sinara-hw/STM_Sys_Board/(list of files, drawings)

Other design files:
Conn_Molex_47491-0001_eec.SchLib
Conn_Molex_47491-0001_eec_0.PcbLib
Cpcis_connectors_P4_P5_P6.SchDoc
CPU.SchDoc
DIO_buffer.schdoc
Ethernet.SchDoc
LVDS_Driver.schdoc
Panel/Panel_STM_Sys_board.PcbDoc
RMII.SchDoc
ST_SYS_Board_Clocking.schdoc
ST_SYS_Board_Config.schdoc
ST_SYS_Board_FPGA.schdoc
ST_SYS_Board_FPGA_SUP.schdoc
STM_System_Board.PCBDOC
STM_System_Board.PrjPCB
STM_System_Board.schdoc
STM_System_Board_Supply.SchDoc
USB.SchDoc
USB_ETH_Mux.SchDoc
