sinara-hw/STM_Sys_Board/(threads)

Thread 3 (2023-02-17):

LVDS routing

gkasprow, 2023-02-17:
Some LVDS lanes are routed to banks that do not support LVDS at all
Moreover some of them are routed to banks supplied from 3.3V (bank 0,1,2)
Some banks need resistors to emulate LVDS outputs (0,1,2)
Lanes 8-15 of each slot must be routed to MLVDS transceivers:
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

marmeladapk, 2023-02-28:
Current differential signal compatibility:

| Signal\Slot |	1 |	2 |	3 |	4 |	5 |	6 |	7 |	8 |
| ----- | ----- | ----- | ----- | ----- | ----- | ----- | ----- | ----- |
| 0	 |	:white_check_mark: |	:heavy_check_mark: |	:heavy_check_mark: |	:heavy_check_mark: |	:heavy_check_mark: |	:white_check_mark: |	:heavy_check_mark: |	:white_check_mark: |
| 1	 |	:white_check_mark: |	:white_check_mark: |	:heavy_check_mark: |	:white_check_mark: |	:heavy_check_mark: |	❌️ |	:white_check_mark: |	❌️ |
| 2	 |	:white_check_mark: |	:heavy_check_mark: |	:heavy_check_mark: |	:heavy_check_mark: |	:heavy_check_mark: |	:heavy_check_mark: |	:heavy_check_mark: |	:heavy_check_mark: |
| 3	 |	:white_check_mark: |	❌️ |	❌️ |	❌️ |	:heavy_check_mark: |	❌️ |	:white_check_mark: |	:white_check_mark: |
| 4	 |	:white_check_mark: |	:white_check_mark: |	❌️ |	:white_check_mark: |	:white_check_mark: |	:white_check_mark: |	:white_check_mark: |	:white_check_mark: |
| 5	 |	:white_check_mark: |	:heavy_check_mark: |	:heavy_check_mark: |	:white_check_mark: |	:heavy_check_mark: |	:white_check_mark: |	:heavy_check_mark: |	❌️ |
| 6	 |	:white_check_mark: |	:white_check_mark: |	:heavy_check_mark: |	:heavy_check_mark: |	:white_check_mark: |	:white_check_mark: |	❌️ |	:white_check_mark: |
| 7	 |	:heavy_check_mark: |	:heavy_check_mark: |	:heavy_check_mark: |	:heavy_check_mark: |	:heavy_check_mark: |	:white_check_mark: |	:heavy_check_mark: |	❌️ |
| 8	 |	 |	 |	❌️ |	:heavy_check_mark: |	 |	 |	 |	 |
| 9	 |	 |	 |	❌️ |	:white_check_mark: |	 |	 |	 |	 |
| 10	 |	 |	 |	❌️ |	:heavy_check_mark: |	 |	 |	 |	 |
| 11	 |	 |	 |	❌️ |	:white_check_mark: |	 |	 |	 |	 |
| 12	 |	 |	 |	:heavy_check_mark: |	:heavy_check_mark: |	 |	 |	 |	 |
| 13	 |	 |	 |	❌️ |	:heavy_check_mark: |	 |	 |	 |	 |
| 14	 |	 |	 |	❌️ |	:white_check_mark: |	 |	 |	 |	 |
| 15	 |	 |	 |	:white_check_mark: |	:white_check_mark: |	 |	 |	 |	 |

:heavy_check_mark:  - full LVDS with I/O

:white_check_mark: - limited LVDS: either output with LVDS25E or input with LVDS io standard

❌️ - not supported

Empty signals are routed to MLVDS transceivers and are supported.

marmeladapk, 2023-10-31:
In terms of I/O we have:

- 40x True LVDS (I/O)
- 40x Emulated LVDS
- 48x SE to LVDS transceivers

True LVDS is the most versatile since it interfaces directly to peripheral modules and can change direction. Then SE to LVDS transceivers are second, while they require writing to a shift register, they also can change signal direction. Emulated LVDS can only be set to input or output at the synthesis time so it's the least versatile.

I analyzed some Sinara modules to assign signals so that if someone were to use them in non-realtime regime it would be the least hassle to do so:

#\Mod | Silpa | HVSUP | DIO | Sampler | Zotino | Urukul | Fastino | Thermostat EEM | Mirny | Zapper
-- | -- | -- | -- | -- | -- | -- | -- | -- | -- | --
0 | O | O | I/O | I | O | O | O | O | O | O
1 | O | O | I/O | I | O | O | O | O | O | O
2 | I | I | I/O | O | I | I | O | I | I | I
3 | O | O | I/O | O | O | O | O | O | O | O
4 | I | O | I/O | O | O | O | O | O | O | I
5 | I | O | I/O | O | O | O | O | O | O | O
6 | O | I | I/O | I | I | O | O | I | O | I
7 | O | I | I/O | O | O | O | I | I | O | O
8 |   |   | I/O | I |   | O |   |   |   |  
9 |   |   | I/O | I |   | O |   |   |   |  
10 |   |   | I/O | I |   | O |   |   |   |  
11 |   |   | I/O | I |   | O |   |   |   |  
12 |   |   | I/O | I |   | O |   |   |   |  
13 |   |   | I/O |   |   | O |   |   |   |  
14 |   |   | I/O |   |   | O |   |   |   |  
15 |   |   | I/O |   |   | O

Most modules have the same I/O on the first 4 signals (SPI).

So my proposal is:

| #    | Type                                                         |
| ---- | ------------------------------------------------------------ |
| 0    | Emulated LVDS, Output SPI CLK                                |
| 1    | Emulated LVDS, Output SPI MOSI                               |
| 2    | True LVDS (I/O), usually Input SPI MISO                      |
| 3    | Emulated LVDS, Output SPI CS                                 |
| 4    | True LVDS (I/O)                                              |
| 5    | True LVDS (I/O)                                              |
| 6    | True LVDS (I/O)                                              |
| 7    | True LVDS (I/O)                                              |
| 8    | SE to LVDS transceiver (slots 1-6) or Emulated LVDS (slots 7, 8) |
| 9    | SE to LVDS transceiver (slots 1-6) or Emulated LVDS (slots 7, 8) |
| 10   | SE to LVDS transceiver (slots 1-6) or Emulated LVDS (slots 7, 8) |
| 11   | SE to LVDS transceiver (slots 1-6) or Emulated LVDS (slots 7, 8) |
| 12   | SE to LVDS transceiver (slots 1-6) or Emulated LVDS (slots 7, 8) |
| 13   | SE to LVDS transceiver (slots 1-6) or Emulated LVDS (slots 7, 8) |
| 14   | SE to LVDS transceiver (slots 1-6) or Emulated LVDS (slots 7, 8) |
| 15   | SE to LVDS transceiver (slots 1-6) or Emulated LVDS (slots 7, 8) |

This will allow us to use autodetection via I2C and adjust signal direction for most modules without requiring new gateware. Having True LVDS on signal 2. will allow us to use first bank of DIO as an output. Only slots 7 and 8 will be somewhat limited on signals 8-15.

Of course that's assuming that I'll be able to route these connections.

Closed 2024-03-26.

Thread 7 (2023-02-22):

I2C PWR pullup

marmeladapk, 2023-02-22:
It should probably be on a P3V3_MP bus, together with LM75, separated by e.g. voltage translator from STM.

If you wanted to change configuration of power supply via I2C through J3, then you're limited by P3V3 pullup of this bus.

Closed 2023-10-19.

Thread 15 (2023-04-04):

CPCIS I2C swapped pins at STM

tprzywoz, 2023-04-04:
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

Green label is correct.

marmeladapk, 2023-04-04:
Ahh... classic one.

Closed 2023-10-19.

Thread 16 (2023-05-25):

Potential latchup when using stm programmer

marmeladapk, 2023-05-25:
After programming STM through CPU JTAG header and leaving it connected, each power cycle increases power consumption by ~5 mA per cycle (the effect stacks). Disconnecting the programmer resets the effect.

jordens, 2023-11-01:
Did you by chance check Stabilizer, Thermostat(-EEM) for this effect already?

marmeladapk, 2024-05-21:
It seems that this was caused by wrong connection to an analog pin with dual function on nucleo programmer, I wasn't able to reproduce that with jlink.

marmeladapk, 2024-05-21:
I just reproduced it.

Thread 19 (2024-03-27):

JTAG

marmeladapk, 2024-03-27:
JTAG mode does not work with stlink. Check if swapping TDI with TDO works.

marmeladapk, 2024-05-21:
Switching TDO with TDI did not help. Logs:

TDI and TDO not swapped, first try after power cycle:

```
probe-rs run --protocol jtag --chip STM32H743ZITx --speed 300 target/thumbv7em-none-eabihf/debug/dual-iir
 WARN probe_rs::probe::jlink: More than one TAP detected, defaulting to tap0
ERROR probe_rs::probe::arm_debug_interface: Unexpected DAP response: 7
ERROR probe_rs::probe::arm_debug_interface: Unexpected DAP response: 7
ERROR probe_rs::probe::arm_debug_interface: Unexpected DAP response: 7
(...)
WARN probe_rs::session: Could not clear all hardware breakpoints: An ARM specific error occurred.

Caused by:
    0: Error using access port
    1: Failed to write register CSW at address 0x00000000
    2: An error occurred in the communication with an access port or debug port.
    3: Target device did not respond to request.                                                             
ERROR probe_rs::probe::arm_debug_interface: Unexpected DAP response: 7                                       
ERROR probe_rs::probe::arm_debug_interface: Unexpected DAP response: 7
(...)                                       
WARN probe_rs::session: Failed to deconfigure device during shutdown: An ARM specific error occurred.

Caused by:
    0: Error using access port
    1: Failed to write register CSW at address 0x00000000
    2: An error occurred in the communication with an access port or debug port.
    3: Target device did not respond to request.                                                                     Error: The flashing procedure failed for 'target/thumbv7em-none-eabihf/debug/dual-iir'.

Caused by:
    0: Something during the interaction with the core went wrong
    1: An ARM specific error occurred.
    2: Error using access port
    3: Failed to write register DRW at address 0x0000000c
    4: An error occurred in the communication with an access port or debug port.
    5: Target device did not respond to request.
```

Subsequent tries:
```
probe-rs run --protocol jtag --chip STM32H743ZITx --speed 300 target/thumbv7em-none-eabihf/debug/dual-iir
Error: Connecting to the chip was unsuccessful.

Caused by:
    0: An error with the usage of the probe occurred
    1: Invalid data length
```

TDO swapped with TDI, all tries:
```
probe-rs run --protocol jtag --chip STM32H743ZITx --speed 300 target/thumbv7em-none-eabihf/debug/dual-iir
Error: Connecting to the chip was unsuccessful.

Caused by:
    0: An error with the usage of the probe occurred
    1: Invalid data length
```

`--connect-under-reset` did not help either.

marmeladapk, 2024-05-21:
SWD works either way, so this is not a high priority.

Thread 21 (2024-04-16):

THT points for GND

MKansio, 2024-04-16:
Solid THT holes come in handy for connect the oscilloscope probe. I suggest adding one between the J7 connector and the IC2 chip, the second one maybe near the U7B , so as not to spoil the already arranged differential lines. Place near SLOT2.LVDS_7_N net maybe?
I propose 1mm hole with round pad to solder regular pin from tht reader.

Closed 2024-05-07.

Thread 22 (2024-04-16):

Description of J13 contacts on the TOP OVERLAY layer

MKansio, 2024-04-16:
It will be useful and safe for the board to describe the pin assignment in the J13 connector, similarly to the J3 and UART3 connectors

Closed 2024-05-07.

Thread 23 (2024-04-16):

ESD Protection on EXT_CLK_IN

MKansio, 2024-04-16:
Lack of ESD protection may damage the IC17 input. The DIO1..4 lines on connectors J1, J2, J4 and J5 are protected.

Closed 2024-05-07.

Thread 25 (2024-05-13):

adding EEMs

nkrackow, 2024-05-13:
Since most Sinara devices out there right now do not have DIOT, a stand alone STM32/ECP5-based controller that also supports EEM would be a lot nicer for the transition period.
Humpback is very limited in [EEM count](https://github.com/sinara-hw/Humpback/issues/16) and [FPGA size](https://github.com/sinara-hw/Humpback/issues/15) and needs the bulky Nucleo board.

I know this is a big ask layout-wise, but would it be possible to somehow squeeze in the EEMs or potentially just do an EEM variant?

jordens, 2024-05-13:
IMHO his is a step into the wrong direction. Evaluate whether you'd be much better off (especially in the long and mid term) with any of the alternative solutions in the shared design space: a dedicated combined cpu+peripheral board, one of the existing cpu/soc "carrier" boards plus a peripheral mezzanine, or a diot controller module plus peripheral module.
Please do consider supporting the move to diot!

marmeladapk, 2024-05-13:
It's not possible to add EEM connectors on this board. But we have a [DIOT EEM Adapter](https://github.com/sinara-hw/DIOT_EEM_Adapter) which enables us to support EEMs until all of them are moved to DIOT form factor.

Closed 2024-05-15.

Thread 30 (2024-09-03):

sequencing

gkasprow, 2024-09-03:
https://github.com/sinara-hw/KASLI-DIOT/issues/42

marmeladapk, 2024-09-24:
On this module there is no direct connection between BP I2C and board I2C AND there is no access via USB only J3 header. I think that adding a header for BP I2C is the easiest thing to do here. Also I don't think it's relevant for this module, since we don't require dedicated gateware for almost all hardware combinations.

As for RST_N - won't having it low just block all modules from powerup?

Thread 31 (2025-03-06):

no power in DI/OT crate

gkasprow, 2025-03-06:
When using a standard DI/OT supply, the STM system board doesn't steer the PS_ON_N line because it doesn't get the supply
5V bus is not used
To make the STM system board run in DIOT care, short two pads of  D4

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
