sinara-hw/STM_Sys_Board/SIM CALC/STM_System_Board.ioc

Mcu.UserName=STM32H743ZITx
PA1.Signal=ETH_REF_CLK
PA11.Signal=USB_OTG_FS_DM
PA12.Signal=USB_OTG_FS_DP
PA2.Signal=ETH_MDIO
PA4.Signal=SPI3_NSS
PA5.Signal=SPI6_SCK
PA6.Signal=SPI6_MISO
PA7.Signal=ETH_CRS_DV
PA9.Signal=USB_OTG_FS_VBUS
PB10.Signal=USART3_TX
PB11.Signal=ETH_TX_EN
PB12.Signal=SPI2_NSS
PB13.Signal=ETH_TXD1
PB2.Signal=SPI3_MOSI
PB7.Signal=I2C1_SDA
PB8.Signal=I2C1_SCL
PC1.Signal=ETH_MDC
PC10.Signal=SPI3_SCK
PC11.Signal=QUADSPI_BK2_NCS
PC2_C.Signal=SPI2_MISO
PC3_C.Signal=SPI2_MOSI
PC4.Signal=ETH_RXD0
PC5.Signal=ETH_RXD1
PC9.Signal=RCC_MCO_2
PD13.Signal=I2C4_SDA
PD3.Signal=SPI2_SCK
PD7.Signal=SPI1_MOSI
PD9.Signal=USART3_RX
PE10.Signal=QUADSPI_BK2_IO3
PE2.Signal=SPI4_SCK
PE3.Signal=GPIO_Output
PE4.Signal=SPI4_NSS
PE5.Signal=SPI4_MISO
PE6.Signal=SPI4_MOSI
PE7.Signal=QUADSPI_BK2_IO0
PE8.Signal=QUADSPI_BK2_IO1
PE9.Signal=QUADSPI_BK2_IO2
PF0.Signal=I2C2_SDA
PF1.Signal=I2C2_SCL
PF10.Signal=QUADSPI_CLK
PF11.Signal=ADC1_INP2
PF12.Signal=ADC1_INN2
PF14.Signal=I2C4_SCL
PF6.Signal=SPI5_NSS
PF7.Signal=SPI5_SCK
PF8.Signal=SPI5_MISO
PF9.Signal=SPI5_MOSI
PG10.Signal=SPI1_NSS
PG11.Signal=SPI1_SCK
PG13.Signal=ETH_TXD0
PG14.Signal=SPI6_MOSI
PG6.Signal=HRTIM_CHE1
PG7.Signal=HRTIM_CHE2
PG8.Signal=SPI6_NSS
PG9.Signal=SPI1_MISO
